MechDeck-Allen/esp32-gesture-controlled-car/cad/README.md

# CAD files

Place the project SolidWorks `.sldprt` part file(s) and exported `.stl` mesh file(s) in this folder before committing. These files were mentioned by the author but were not attached in the current upload, so they are not included in this archive yet.
