MechDeck-Allen/esp32-gesture-controlled-car/media/photos/README.md

# Build photos

## 01-car-and-transmitter-overview.jpeg

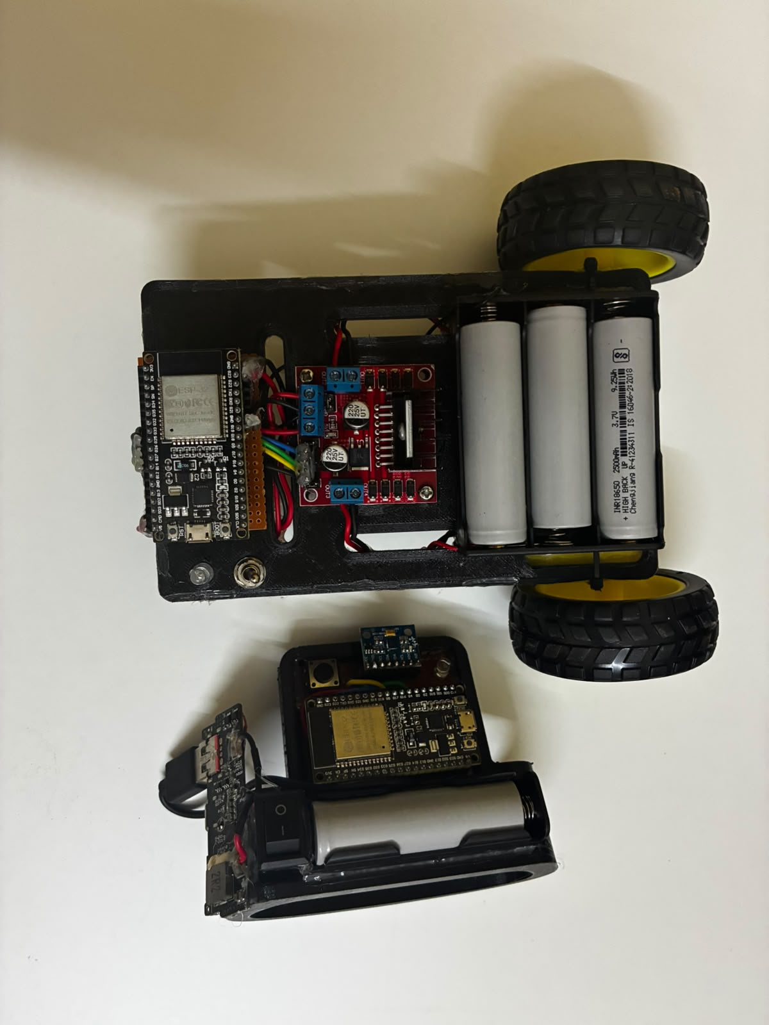
[picture p1: media/photos/01-car-and-transmitter-overview.jpeg]


## 02-car-top-view.jpeg

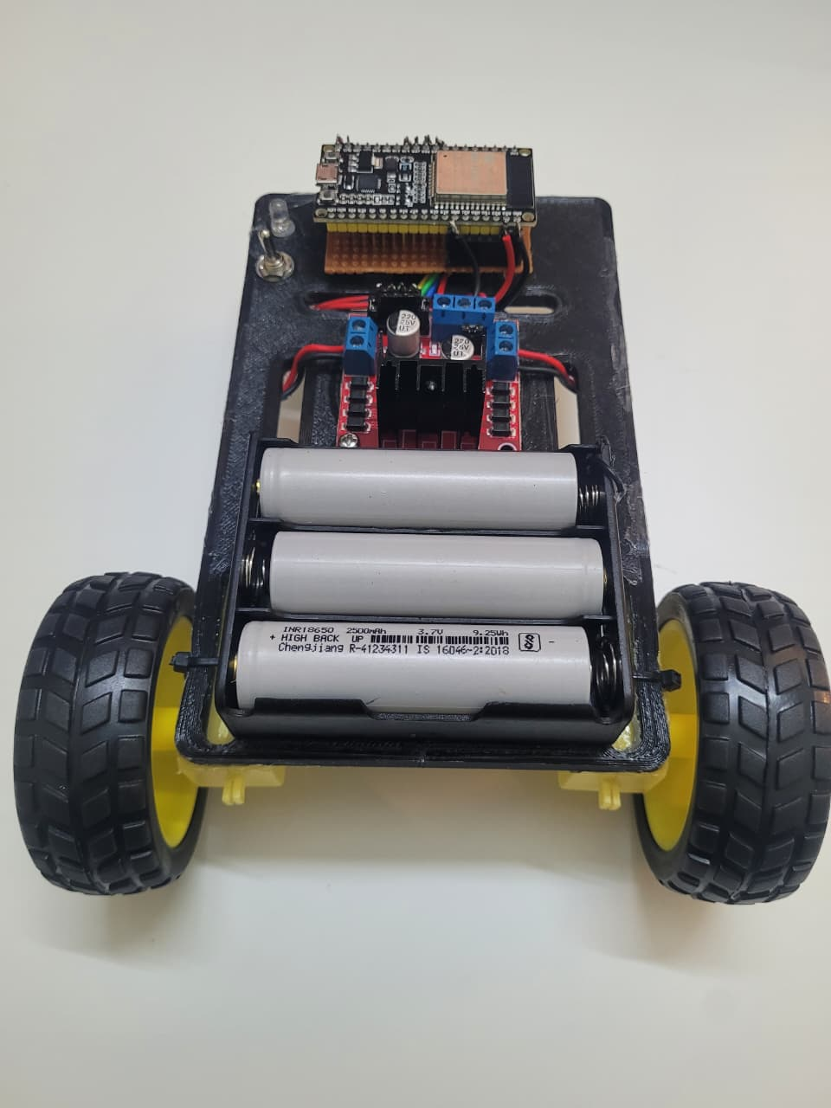
[picture p2: media/photos/02-car-top-view.jpeg]


## 03-car-side-view.jpeg

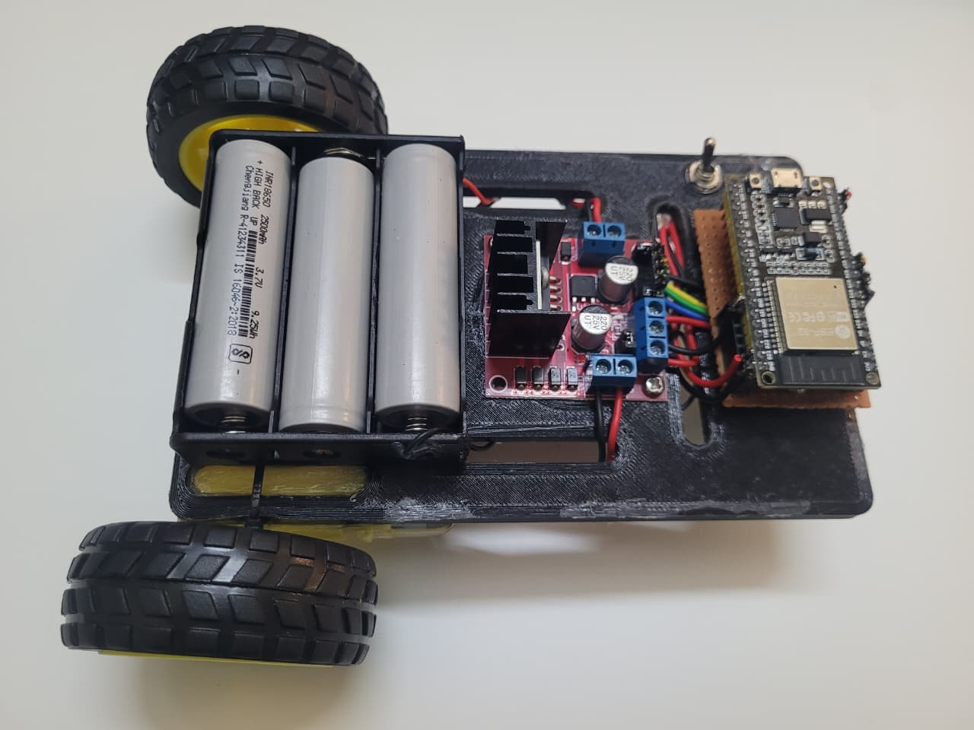
[picture p3: media/photos/03-car-side-view.jpeg]


## 04-transmitter-top-view.jpeg

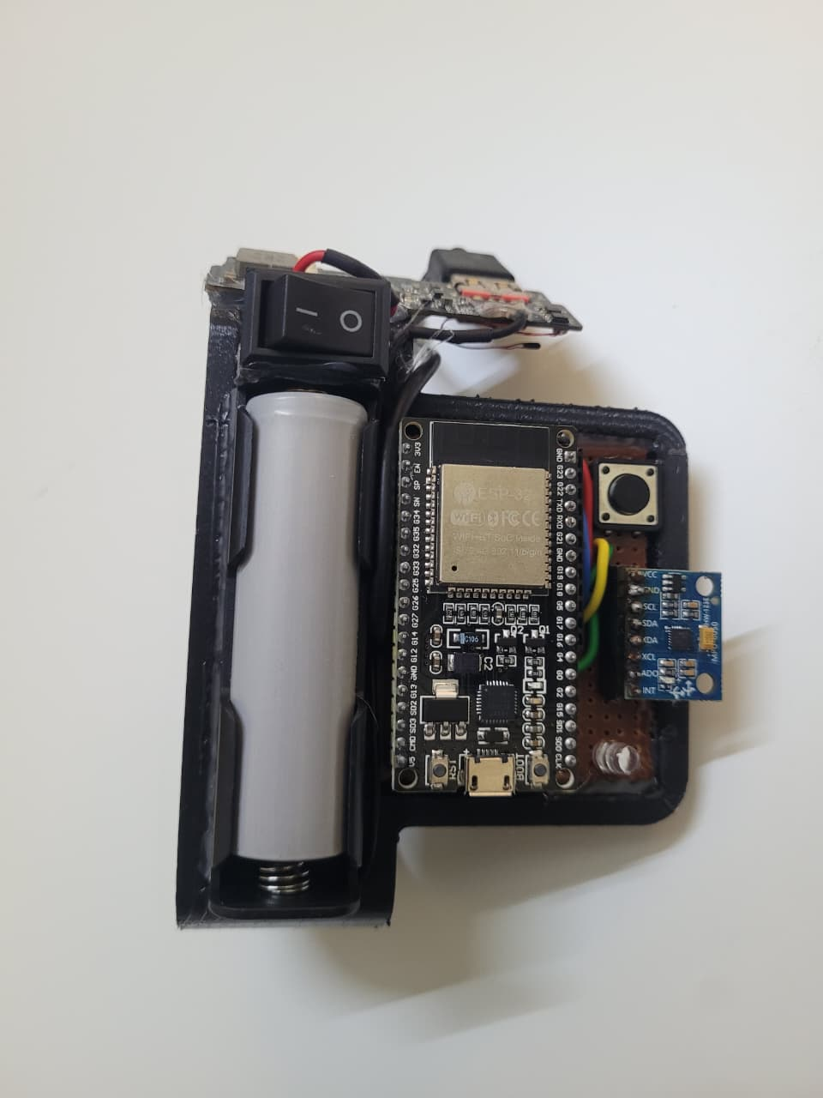
[picture p4: media/photos/04-transmitter-top-view.jpeg]


## 05-transmitter-handheld-view.jpeg

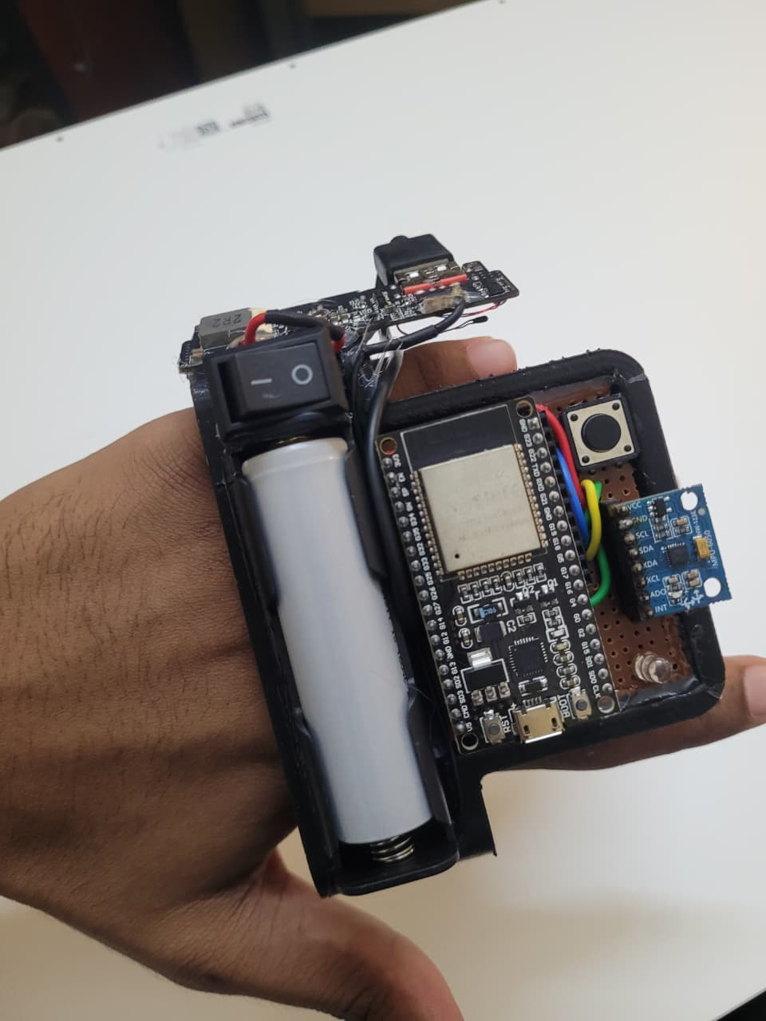
[picture p5: media/photos/05-transmitter-handheld-view.jpeg]
