MechDeck-Allen/esp32-gesture-controlled-car/cad/hand_frame.SLDPRT

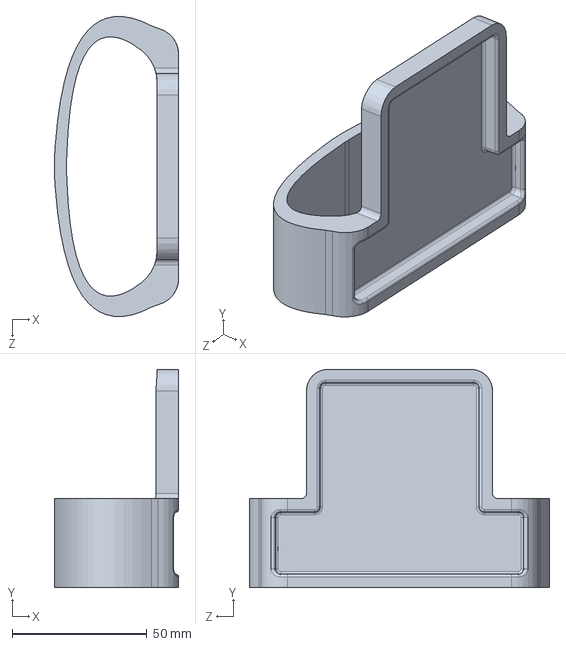
[picture p6: CAD file, 2026-10-10]
cad/hand_frame.SLDPRT
46.1 x 81.0 x 111.2 mm
