MechDeck-Allen/esp32-gesture-controlled-car/cad/car_chasis.SLDPRT

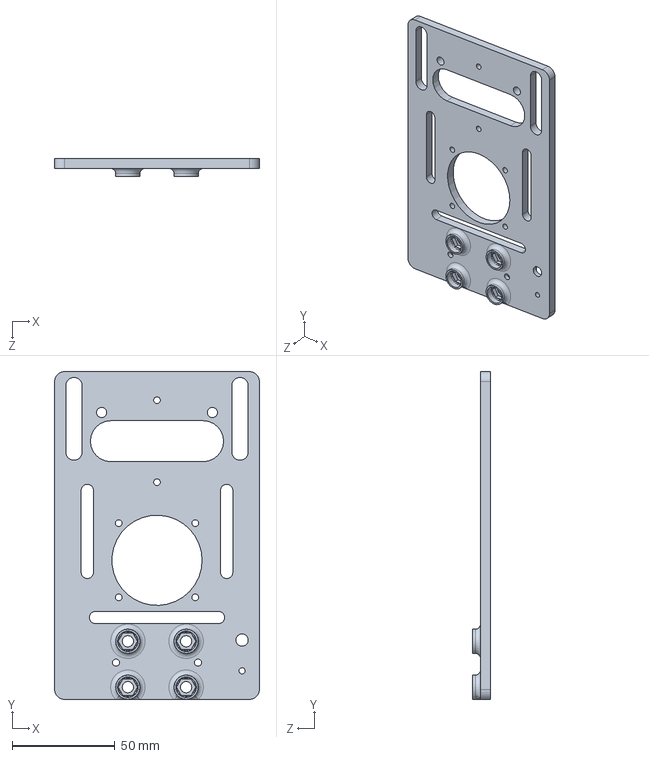
[picture p7: CAD file, 2026-10-10]
cad/car_chasis.SLDPRT
100.0 x 160.0 x 9.00 mm
