MechDeck-Allen/esp32-gesture-controlled-car/(list of files, cad)

Other CAD files:
cad/car_chasis.STL
cad/hand_frame.STL
