MechDeck-Allen/esp32-gesture-controlled-car/(commit log)

2026-10-10 Add ESP32 gesture-controlled car project
    [car_chasis.SLDPRT, car_chasis.STL, hand_frame.SLDPRT, hand_frame.STL]
2026-10-10 Clarify CAD file location in README
    Updated README to clarify CAD file availability and location.
2026-10-10 Move project files to repository root
    [car_chasis.SLDPRT, car_chasis.STL, hand_frame.SLDPRT, hand_frame.STL]
